OPEnSLab-OSU/Wisp/assets/schematics/wisp_v2.pdf

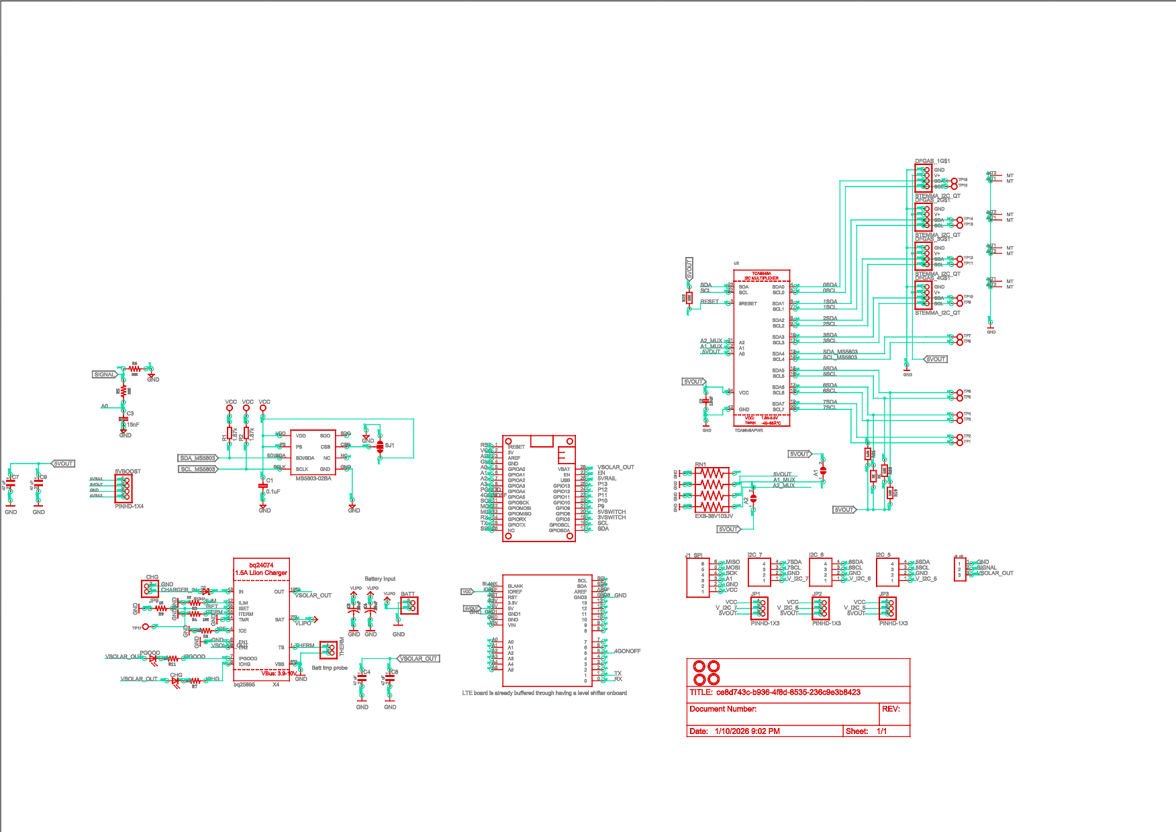
[picture p3: page 1]
