OPEnSLab-OSU/Wisp/(commit log)

2025-12-05 Revise README with Wisp V2 details and sensor updates
    Updated sensor specifications and added details for Wisp V2.
2025-12-06 Update README with Wisp V1 and V2 sensor specs
    Added specifications for Wisp V1 and Wisp V2 sensors, including sensor details and images.
2026-05-26 Implement watchdog timer for system stability
    Added watchdog functionality to monitor system health and prevent hangs.
2026-05-26 Refactor I2C multiplexer and update configurations
2026-06-25 Disable watchdog during measure for V1
    In the field this was observed to cause units to reset while the SEN55 gathered
    data. Disabling the watchdog for the measurement step, while not ideal,
    prevents this from occurring and allows measurement to continue as expected.
    This issue presumably doesn't affect the V2s because the SEN66 is able to
    provide data faster than the SEN55, responding within the 16 second watchdog
    timeout interval.
    [Wisp_Code.ino]
2026-08-05 Use constant for sample frequency
2026-08-05 Keep rails on during sleep to prevent surges
    This is a preventative measure against power surges that occur when enabling power rails during wakeup
    [Wisp_Code.ino]
2026-09-30 Switch order of v1 and v2
2026-09-30 update sensor lineup in v2 description
2026-09-30 PM sensor data in v2 table
2026-09-30 wip v2 sensor specs
2026-10-01 done with sensor specs?
2026-10-01 fix gravity sensor header
2026-10-02 Remove redundant watchdog reset call
    [Wisp_Code.ino]
2026-10-03 move hardware section of v2 around, cut repeat info
2026-10-05 switch v1 and v2 photos out for prettier ones
2026-10-05 Switch to AGU26 abstract
2026-10-05 add v2 BOM
    [WISP_v2_BOM_2026.xlsx]
2026-10-05 Angle bracket emails
2026-10-06 Cut down and move novel info to v2
2026-10-06 add todo entry for gravity sensors
2026-10-07 add gravity sensor datasheetish
2026-10-25 remove bad graphs, bad power draw
2026-10-25 add current power budget
2026-10-31 Update Wisp v2 power consumption information
